MINKI-2687/RISC-V-Multi-cycle-RV32I/rtl/APB_FND.sv

`timescale 1ns / 1ps

module APB_FND (
    input               pclk,
    input               preset,
    input        [31:0] paddr,
    input        [31:0] pwdata,
    input               pwrite,
    input               penable,
    input               psel,
    output logic [31:0] prdata,
    output logic        pready,
    output logic [ 3:0] o_fnd_digit,
    output logic [ 7:0] o_fnd_data
);

    localparam [11:0] FND_CTRL_ADDR = 12'h000;
    localparam [11:0] FND_ODATA_ADDR = 12'h004;

    logic [15:0] fnd_odata_reg, fnd_ctrl_reg;

    assign pready = (penable & psel) ? 1'b1 : 1'b0;

    assign prdata  = (paddr[11:0] == FND_CTRL_ADDR)  ? {16'h0000, fnd_ctrl_reg}  : 
                     (paddr[11:0] == FND_ODATA_ADDR) ? {16'h0000, fnd_odata_reg} : 
                     32'hxxxx_xxxx;

    always_ff @(posedge pclk, posedge preset) begin
        if (preset) begin
            fnd_ctrl_reg  <= 16'd0;
            fnd_odata_reg <= 16'd0;
        end else begin
            if (pready & pwrite) begin
                case (paddr[11:0])
                    FND_CTRL_ADDR:  fnd_ctrl_reg <= pwdata[15:0];
                    FND_ODATA_ADDR: fnd_odata_reg <= pwdata[15:0];
                endcase
            end
        end
    end

    fnd_controller U_FND_CTRL (
        .clk        (pclk),
        .reset      (preset),
        .fnd_in_data(fnd_odata_reg[13:0]),
        .fnd_digit  (o_fnd_digit),
        .fnd_data   (o_fnd_data)
    );
endmodule

module fnd_controller (
    input         clk,
    input         reset,
    input  [13:0] fnd_in_data,
    output [ 3:0] fnd_digit,
    output [ 7:0] fnd_data
);
    wire [3:0] w_digit_1, w_digit_10, w_digit_100, w_digit_1000, w_mux_4x1_out;
    wire [1:0] w_digit_sel;
    wire w_1khz;

    digit_splitter U_DIGIT_SPL (
        .in_data   (fnd_in_data),
        .digit_1   (w_digit_1),
        .digit_10  (w_digit_10),
        .digit_100 (w_digit_100),
        .digit_1000(w_digit_1000)
    );

    clk_div U_CLK_DIV (
        .clk   (clk),
        .reset (reset),
        .o_1khz(w_1khz)
    );
    counter_4 U_COUNTER_4 (
        .clk      (clk),
        .reset    (reset),
        .en_1khz  (w_1khz),
        .digit_sel(w_digit_sel)
    );

    decoder_2x4 U_DECODER_2x4 (
        .digit_sel  (w_digit_sel),
        .decoder_out(fnd_digit)
    );

    mux_4x1 U_MUX_4x1 (
        .sel       (w_digit_sel),
        .digit_1   (w_digit_1),
        .digit_10  (w_digit_10),
        .digit_100 (w_digit_100),
        .digit_1000(w_digit_1000),
        .mux_out   (w_mux_4x1_out)
    );

    bcd U_BCD (
        .bcd     (w_mux_4x1_out),
        .fnd_data(fnd_data)
    );
endmodule

module clk_div (
    input      clk,
    input      reset,
    output reg o_1khz
);

    //reg [16:0] counter_r;
    reg [$clog2(100_000)-1:0] counter_r;

    always @(posedge clk, posedge reset) begin
        if (reset) begin
            counter_r <= 0;
            o_1khz    <= 1'b0;
        end else begin
            if (counter_r == 9) begin
                counter_r <= 0;
                o_1khz    <= 1'b1;
            end else begin
                counter_r <= counter_r + 1;
                o_1khz    <= 1'b0;
            end
        end
    end
endmodule

module counter_4 (
    input        clk,
    input        reset,
    input        en_1khz,
    output [1:0] digit_sel
);

    reg [1:0] counter_r;

    assign digit_sel = counter_r;

    always @(posedge clk, posedge reset) begin
        if (reset) begin
            counter_r <= 0;  // init counter_r
        end else if (en_1khz) begin
            // to do
            counter_r <= counter_r + 1;
        end
    end
endmodule

module digit_splitter (
    input  [13:0] in_data,
    output [ 3:0] digit_1,
    output [ 3:0] digit_10,
    output [ 3:0] digit_100,
    output [ 3:0] digit_1000
);

    assign digit_1    = in_data % 10;
    assign digit_10   = (in_data / 10) % 10;
    assign digit_100  = (in_data / 100) % 10;
    assign digit_1000 = (in_data / 1000) % 10;
endmodule

module decoder_2x4 (
    input      [1:0] digit_sel,
    output reg [3:0] decoder_out
);

    always @(digit_sel) begin
        case (digit_sel)
            2'b00: decoder_out = 4'b1110;
            2'b01: decoder_out = 4'b1101;
            2'b10: decoder_out = 4'b1011;
            2'b11: decoder_out = 4'b0111;
        endcase
    end
endmodule

module mux_4x1 (
    input      [1:0] sel,
    input      [3:0] digit_1,
    input      [3:0] digit_10,
    input      [3:0] digit_100,
    input      [3:0] digit_1000,
    output reg [3:0] mux_out
);

    always @(*) begin
        case (sel)
            2'b00: mux_out = digit_1;
            2'b01: mux_out = digit_10;
            2'b10: mux_out = digit_100;
            2'b11: mux_out = digit_1000;
        endcase
    end
endmodule

module bcd (
    input      [3:0] bcd,
    output reg [7:0] fnd_data  // always output must reg type
);
    always @(bcd) begin
        case (bcd)
            4'd0: fnd_data = 8'hC0;
            4'd1: fnd_data = 8'hF9;
            4'd2: fnd_data = 8'hA4;
            4'd3: fnd_data = 8'hB0;
            4'd4: fnd_data = 8'h99;
            4'd5: fnd_data = 8'h92;
            4'd6: fnd_data = 8'h82;
            4'd7: fnd_data = 8'hF8;
            4'd8: fnd_data = 8'h80;
            4'd9: fnd_data = 8'h90;
            default: fnd_data = 8'hFF;
        endcase
    end
endmodule
